sinara-hw/Almazny/README.md

# Almazny

4-channel 12GHz mezzanine for [Mirny](https://github.com/sinara-hw/mirny/wiki)

## Design Files

Design files (schematics, PCB layouts, BOMs) can be found at [mirny/Releases](https://github.com/sinara-hw/Almazny/releases).

## Wiki

More information can be found on the [wiki](https://github.com/sinara-hw/Almazny/wiki).
