sinara-hw/Almazny/ALMAZNY Stack-up FR408HR_Technosystem.pdf

Soldermask | Df | Er
L1 | | | 35 | um
CORE | 0,0092 | 3,69 | 200 | um
L2 | | | 35 | um
PREPREG | | | 110 | um
CORE | 0,0092 | | 300 | um
PREPREG | | | 110 | um
L3 | | | 35 | um
CORE | 0,0092 | 3,69 | 200 | um
L4 | | | 35 | um
Soldermask
TechnoSystem Sp. z o.o. ul. Słoneczna 125 05-506 Kolonia Lesznowola | Data: | 04.01.2021
| Rewizja: | 1.1
| Przygotował: | P.Syryczyk

2116

2116
FR408HR | 3,58

FR408HR

ALMAZNY Stack-up 4 FR408HR

FR408HR
