sinara-hw/Almazny/(list of files, drawings)

Other design files:
Almazny.PcbDoc
Almazny.PrjPCB
Almazny_channel.SchDoc
Almazny_PS.SchDoc
Almazny_top.SchDoc
LT3094.SchDoc
panel/Panel_Almazny.PcbDoc
panel/Panel_Almazny.PrjPCB
