sinara-hw/Almazny/(threads)

Thread 1 (2020-07-25):

High frequency mezzanine

cjbe, 2020-07-25:
How far advanced are the plans for the high frequency mezzanine?

I need some sources around 5-12 GHz for which Mirny+mezzanine would be ideal. For my use case all I would require on the mezzanine is matching and switching. Switchable attenuation would be a nice to have.

Does anyone have any appetite to specify / use / build this? If so I can put some effort into crystallising specifications.

cjbe, 2020-12-17:
@gkasprow @shanasz any idea when we will be able to get some hardware made? I am keen to try Almazny out!

gkasprow, 2020-12-18:
It's already finished, @shanasz can we produce it?

cjbe, 2021-01-05:
I see a production release! @gkasprow what is the best way of getting hold of one once smoke tests pass?

Closed 2022-06-21.

Thread 2 (2020-10-01):

schematic review

gkasprow, 2020-10-01:
@shanasz
- [x] use LDOs from other designs (Urukul, Phaser, Zotino, Fastino. The LDOs are known to be unstable.
- [x] the Mirny has a new connector with 16 GPIOs
- [x] I'm not sure standard components (C14,C17,C18) would work for 12GHz. Did you check their resonant frequency?
- [x] I'm not sure if resistive divider would work for 12GHz. it needs simulation, but safer would be to place integrated one
- [ ] SPI levels are 3V3. Use HCT595 that has LVTTL levels compatible with LVCMOS signaling.
- [ ] Are C16/C26/C24 sufficient for the decoupling of such high RF?
- [x] run LTM8074 from 12V. 7V5 is a low noise rail. This inverting converter is quite unfortunate, It has issues with light loading and injects a lot of noise to the input rail. I would recommend using one from Shuttler design which works as a real inverting one.
- [ ] consider supplying HMC424 from positive levels. Tie VCC to GND and GND to +5V. The logic levels would be simply inverted.
- [x] the attenuator control levels are wrong.
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

shanasz, 2020-10-26:
So:
AD 3 : In case of DC-blocking capacitor, we need the resonance to carry the signal. Generally 0402 and 0201 capacitors can be used up to 10...15 GHz introducing loss <1dB. Few RF coupling caps are removed because amplifier is internally coupled and attenuator is DC-compatible). The one protecting switch output remained, I used AVX 1pF 0201 ACCU-P (AVX RF-series) capacitor. Other option was 10pF Skyworks Metal Insulator Silicon (MIS) chip capacitor for low loss (these DC-blocks operate up to 26GHz) but it would be a bit overengineering.
AD 7 : inverting converter changed to TPS63710DRR, supplied from P12V0.
AD 1: LDOs changed to LT4035 and LT3094
AD 2 : Ok, changed.
AD 5 : Ok, changed. Logic levels corrected.
AD 6 : VCC polygon to GND plane capacitance will decouple higher frequencies.
AD 4: Pi attenuator is changed to integrated. Although RF resistors <100R operate up to 20GHz or more, integrated is more practical.
AD 8 and 9 : Levels corrected. Are You sure about supplying HMC424 from positive? I think it may be risky.

gkasprow, 2020-12-02:
AD3: IN case of caps, the circuit must be wideband, I see no advantage of using resonant modes.
There are wideband caps available ( i.e. ATC530L104KT16T)

AD8. Why it is risky? inputs and outputs are AC coupled anyway.  It does not matter how you swap the supplies.
Let's leave as it is now. It's easier to provide correct GND in such way.

shanasz, 2020-12-02:
AD3: I may have expressed myself wrongly, I called "resonance" the pass-band of series capacitor between capacitive reflection and inductive reflection, I didnt mean to use higher resonances.

AD8. Yees, but in this case I would have to connect 4 GND pins and central pad to a  5V-supplied polygon coupled with ground plane and therefore force signal to change reference planes - of course it is possible but if I prefer to avoid it. Additionally now DC component is equal 0 nad I can remove DC-blocking capacitors, from signal path.

Closed 2022-06-21.

Thread 3 (2020-12-23):

PCB review

gkasprow, 2020-12-23:
the connector should be on the other side of the PCB - it must match with Mirny IO connector!
It must be female type. Copy it from stabilizer mezzanine. Make sure the pins numbering is mirrored
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

gkasprow, 2021-07-31:
@shanasz
I asked you (look at post above) to copy the connector from the Stabilizer mezzanine.
The one you used doesn't match.
Moreover the connector is shifted
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

gkasprow, 2022-06-21:
fixed

Closed 2022-06-21.

Thread 4 (2021-07-31):

missing mounting HW

gkasprow, 2021-07-31:
@shanasz please add to the BOM
- mounting screws + washers + standoffs (copy if from Stabilizer mezzanine)
- SMP bullets

jordens, 2021-07-31:
IME the screw heads on the mirny underside are thicker than allowed and interfere with the adjacent panel's gasket. Same on stabilizer/pounder. Is there something we can do?

jordens, 2022-06-21:
You had some really nice soldered or press-fit standoffs or screws on dio-mcx IIRC. Those would be great.

gkasprow, 2022-06-21:
yes, but here I need nontypical height. These inserts are available only in 1mm increments
I used such in the Thermostat EEM design. DIO_MCX has classical ones since non-typical height was needed as well.

Closed 2022-06-22.

Thread 5 (2021-07-31):

front panel bumps into SMA connectors

sbourdeauducq, 2021-07-31:
Dirty dremel solution:
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

gkasprow, 2021-07-31:
common panel with Mirny will solve the issue.

gkasprow, 2022-06-21:
@jordens this is a common panel design. Any comment?
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

jordens, 2022-06-22:
* Maybe add the LEDs mentioned in https://github.com/sinara-hw/Almazny/issues/7#issuecomment-1163261142
* Maybe also an additional LED for Almazny PGOOD.
* Below "HF MEZZANINE" there is space for "2X LF FREQUENCY"
* There should be two version numbers at the bottom. I know it is tricky. But let's put v1.2 for Mirny and v1.1 for Almazny (and call them like that).

jordens, 2022-06-22:
Very good.
Are you sure about the version numbers? Shouldn't this be Almazny 1.1?

jordens, 2022-06-22:
As long as files, front panel and board markings are consistent for the next version, it's fine.

jordens, 2024-08-21:
Fixed by common panel

Closed 2024-08-21.

Thread 7 (2021-11-17):

Mezzanine interface changes

Spaqin, 2021-11-17:
There are 11 signals that control Almazny, plus one to read back (``PGOOD``). And they are all around the IO port.
However, Almazny could work with older, 8-pin connector with almost no loss in functionality, while also keeping ARTIQ driver intact.

The suggestion is to change the pinout as follows:
MEZZ_IO0 - SER_MOSI
MEZZ_IO1 - SER_CLK
MEZZ_IO2 - REG_LATCH1
MEZZ_IO3 - REG_LATCH2
MEZZ_IO4 - REG_LATCH3
MEZZ_IO5 - REG_LATCH4
MEZZ_IO6 - REG_OE
MEZZ_IO7 - PGOOD

REG_OE would a signal that goes to all 4 shift registers (previously REG_NOE1..4), with an inverter in between, to convert it from NOE to OE. Individual RF output can be still adjusted by setting the shift registers individually. The inverter is there to make sure that on powerup the outputs are all disabled, so no unattenuated output is accidentally sent before the shift registers are initialized.

REG_CLEAR (SRCLR#) should be connected to high level at all times. There seems to be no need to clear all the registers at once - that can be done by setting them to 0.

gkasprow, 2022-06-21:
@jordens how would we detect the mezzanine version? some IOs pulled to GND?

jordens, 2022-06-21:
IMO since the gateware for the old version is unlikely to ever make it into the "standard mirny gateware", we don't need to distinguish. We can always use the dip switches on mirny to indicate "system configuration", i.e. also mezzanine versions.

gkasprow, 2022-06-21:
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

jordens, 2022-06-22:
Ok. That probably didn't work in v1.0. No inversion, no pullup. But keep it.
Still, connect one LED to the unused shift register output QH. Move PGOOD. Add a PGOOD LED, add eeprom and lm75.

gkasprow, 2022-06-22:
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
I'm not sure about EEPROM. If they share same address how would you program them?

jordens, 2022-06-22:
What I meant is:
* PGOOD on MEZZ_IO2, pin 13 as it was in v1.0
* MOSI, CLK, 4xLATCH, NOE on the remaining MEZZ_IO0-7 the way you like them.
* no additional shiftreg
* Use QH output of the four shiftregs to drive four green LEDs one for each channel
* Add PGOOD green front panel LED

jordens, 2022-06-22:
* They should have different addresses. I thought there were address select pins on those eeproms. Aren't there?

jordens, 2022-06-22:
Yeah. Then the EEPROM isn't critical. LM75 on a non-colliding address is already useful.

gkasprow, 2022-06-22:
How to call these additional green LEDs?

gkasprow, 2022-06-22:
L8...L11 ?

jordens, 2022-06-22:
Yes.

kaolpr, 2022-11-21:
As #11 will require modifications, maybe we could reevaluate the lack of EEPROM? 24AA02**5**E48  does have address pins and we could agree on the addressing of mezzanine EEPROMs.

gkasprow, 2023-03-08:
@kaolpr please check
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

gkasprow, 2023-03-08:
IC10 is DNP by default

kaolpr, 2023-03-09:
Unfortunately, this will not work.

For it to work, we will need to change Mirny EEPROM. Mirny has, as all Sinara modules, 24AA02E48.
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
So no matter how `Ax` lines are set we'll hit Mirny EEPROM.

However, we can keep it on Mirny but with **DNP jumper** on power supply and move to 24AA02**5**E48 on Mirny in the fitire release.

gkasprow, 2023-03-09:
let's make the EEPROMs DNP

jordens, 2024-08-21:
done in v1.2

Thread 14 (2023-03-15):

v1.3 review vol2

shanasz, 2023-03-15:
There few parts are not available on popular distributor stocks:
LM75AIMM - will be available in august 2023, but version LM75AIM (in SOIC package, same pinout) is available.
BSS138LT1G - should be back in 2024. Can be replaced with Vishay SI2302CDS-T1-BE3 (same footprint and pinout).
LT3094EDD#PBF - only 28 parts available in Farnell (and nowhere else). Will it be a problem?
B82498B3689K - not available anymore, can be replaced with B82498F3689K (same footprint)
