sinara-hw/Almazny/(commit log)

2020-09-29 basic schematic added
    [Almazny.PcbDoc, Almazny.PrjPCB, Almazny_channel.SchDoc, Almazny_top.SchDoc]
2020-10-01 schematics V1
    [Almazny.PrjPCB, Almazny_channel.SchDoc, Almazny_top.SchDoc]
2020-10-22 schematics corrected ,PCB advanced (but not finished!)
    [Almazny.PrjPCB, Almazny_channel.SchDoc, Almazny_top.SchDoc]
2020-10-22 added files missing in previous commit
    [AlmaznyLib.PcbLib, AlmaznyLib.SchLib, Almazny_PS.SchDoc, LT3094.SchDoc]
2020-12-02 DRC ok, ongoing self-check
    [Almazny.PrjPCB, Almazny_channel.SchDoc]
2021-01-07 added panel
    [Almazny.PrjPCB, Panel_Almazny.PcbDoc, Panel_Almazny.PrjPCB]
2021-04-19 Final manufacturing files (v1.1), optimized in HFSS.
    [Almazny.GBL, Almazny.GBO, Almazny.GBP, Almazny.GBS, Almazny.GKO, Almazny.GM1, Almazny.GTL, Almazny.GTO]
2021-06-08 Stackup changed due to manufacturers needs. Board re-simuated, microstrip width and antipads modified.
    [Almazny.GBL, Almazny.GBO, Almazny.GBP, Almazny.GBS, Almazny.GKO, Almazny.GM1, Almazny.GTL, Almazny.GTO]
2021-07-31 added Mirny step to show connector issue
2022-09-13 v1.2 rc1
    [Almazny.PrjPCB, Almazny_PS.SchDoc, Almazny_channel.SchDoc, Almazny_top.SchDoc, Panel_Almazny.PcbDoc]
2023-03-08 remove production files from repo
    [Almazny.GBL, Almazny.GBO, Almazny.GBP, Almazny.GBS, Almazny.GKO, Almazny.GM1, Almazny.GTL, Almazny.GTO]
2023-03-08 removed libs
    [AlmaznyLib.PcbLib, AlmaznyLib.SchLib]
2023-03-09 v1.3rc2 EEPROMs removed due to collision
    [Almazny.PrjPCB]
2023-03-14 fixed #13
    [Almazny.PrjPCB]
2023-07-03 v1.3.1 - minor layout fixes - version fixed - Active BoM added
    [Almazny.PrjPCB, Almazny_PS.SchDoc, Almazny_channel.SchDoc, Almazny_top.SchDoc, LT3094.SchDoc, Panel_Almazny.PcbDoc, Panel_Almazny.PrjPCB]
2023-07-03 v1.3.1rc2 - Outline changed (closed) - Component class form mechanical objects added - Rules for 3D collision and screws overlay on exposed copper added - 3D bodies moved from Mechanical 1 to Mechani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
    [Almazny.PrjPCB, Almazny_PS.SchDoc, Almazny_top.SchDoc]
